mpasserini/arduino_monotron/schematics/monotron_sch.png

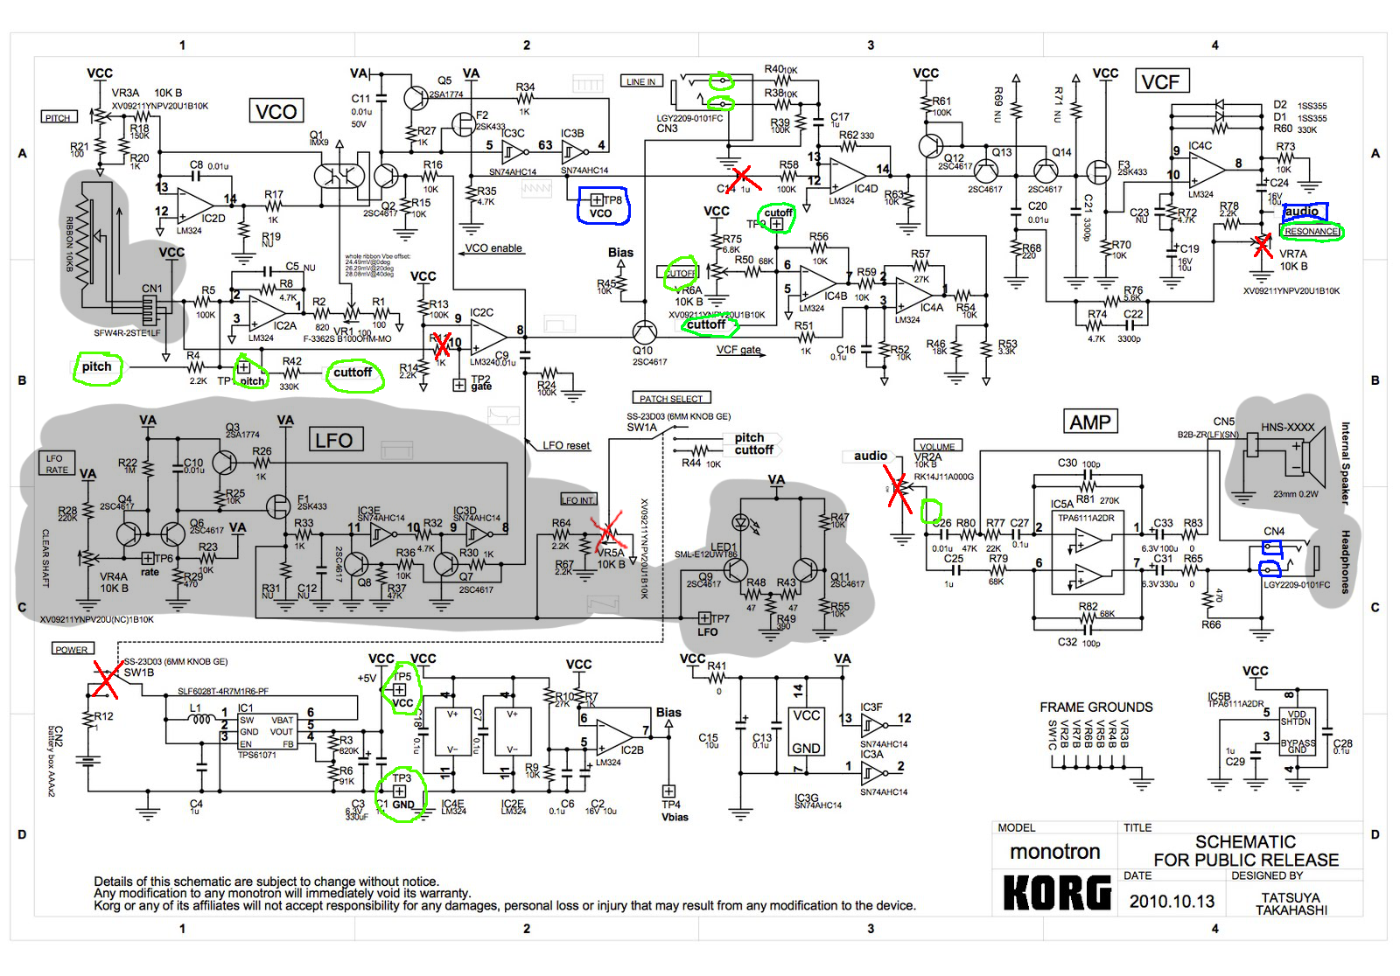
schematics/monotron_sch.png
