mpasserini/arduino_monotron/schematics/schematics1.jpg

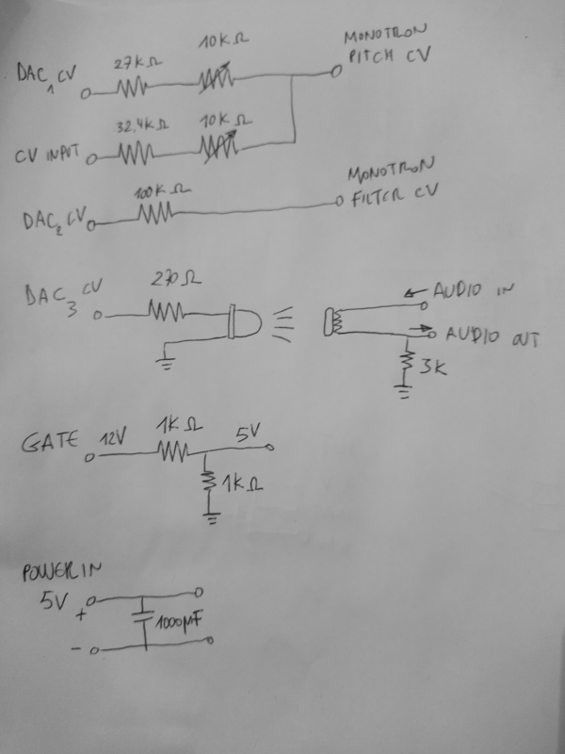
schematics/schematics1.jpg
