mpasserini/arduino_monotron/schematics/schematics2.jpg

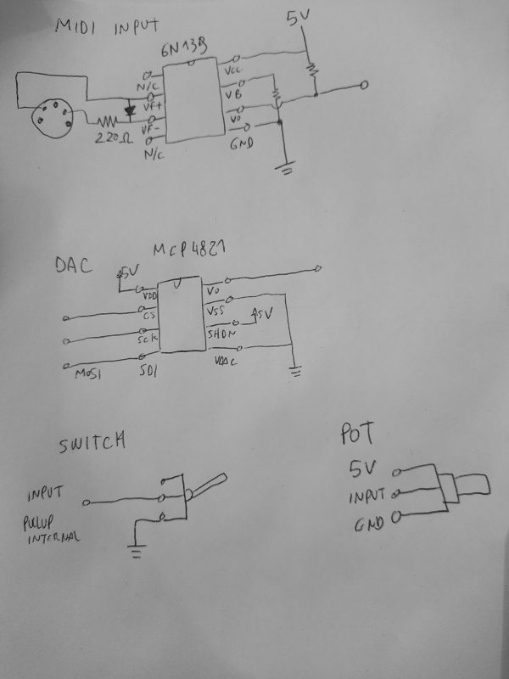
schematics/schematics2.jpg
