mpasserini/arduino_monotron/(commit log)

2016-01-07 Added filter control and filter envelope
2016-01-12 pitch bend
2016-01-14 more midi CC for pitch bend, portament oand legato, portamento time control, vcf env control
2016-01-16 basic lfo forms added, currently buggy
2021-04-03 added switch and pot input
2021-04-04 fixed adsr inputs now they work correctly when adsr1/2 is changes
    [arduino_monotron.ino]
2021-04-06 added arduino_ci in order to run unit tests
2021-04-06 added arduino_ci empty test
2021-04-08 adding arduino-cli to install libraries for arduino_ci
2021-04-08 trying to fix arduino_ci
2021-04-08 removed arduino_ci for now
2021-04-09 swapped switch pins, added gate input
    [arduino_monotron.ino]
2021-04-10 fixed wave change pot, not works well will lfo
    [arduino_monotron.ino]
2021-04-11 fixed portamento pot direction
    [arduino_monotron.ino]
2021-04-11 added velocity
2021-04-11 added filter tracking
2021-04-26 added schematics
2021-04-26 scaled schematics
2021-04-26 fixed schematics
